Szabrownick/spool-film-processor/docs/screens/06_chem_fresh.png

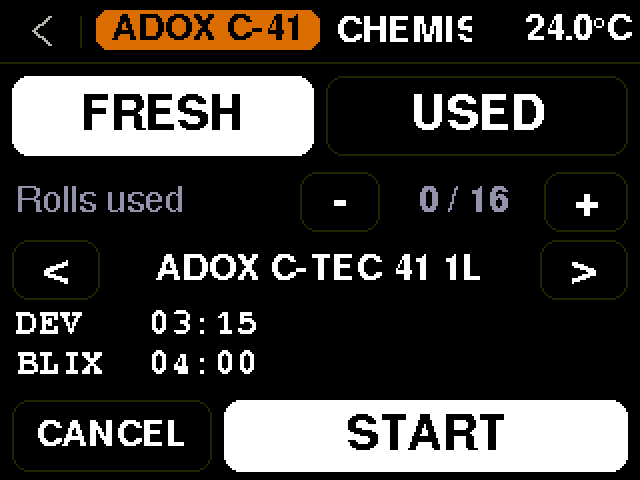
docs/screens/06_chem_fresh.png
