Szabrownick/spool-film-processor/docs/screens/19_confirm.png

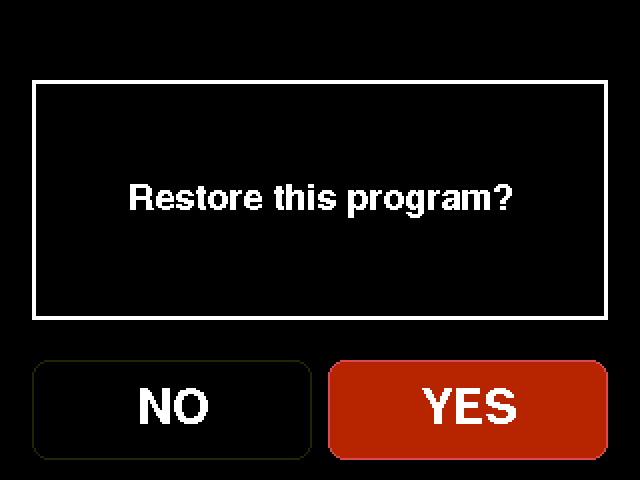
docs/screens/19_confirm.png
