Szabrownick/spool-film-processor/docs/screens/14b_step_edit_2.png

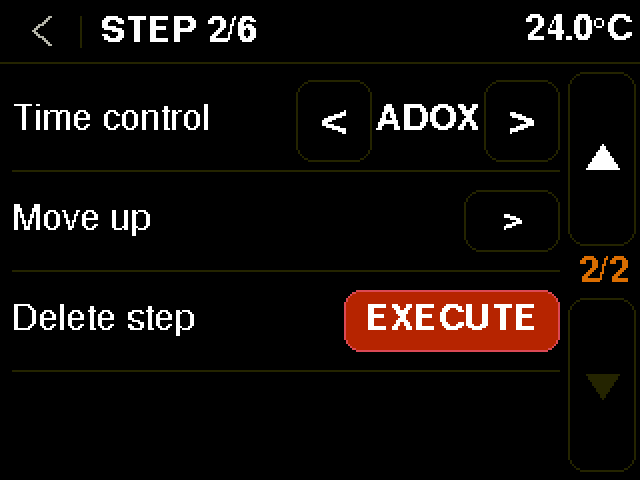
docs/screens/14b_step_edit_2.png
