Szabrownick/spool-film-processor/SpoolFilmProcessor/spool_logo.h

// Napis SPOOL (Loupe Negative Lab, logo/Spool logo.png) - 256 x 59 px, 1 bit/px, MSB = lewy piksel
#pragma once
#define SPOOL_WORD_W 256
#define SPOOL_WORD_H 59
static const uint8_t SPOOL_WORD[] PROGMEM = {
  0x00,0x00,0x0F,0x80,0x00,0x00,0x00,0x00,0x00,0x00,0x00,0x00,0x00,0x00,0x00,0x00,0x00,0x00,0x00,0x00,0x00,0x00,0x00,0x00,0x00,0x00,0x00,0x00,0x00,0x00,0x00,0x00,
  0x00,0x01,0xFF,0xFC,0x00,0x00,0x1F,0xFF,0xFF,0xC0,0x00,0x00,0x00,0x00,0x00,0xFF,0xFF,0xFF,0x00,0x00,0x00,0x00,0x00,0xF0,0x00,0x00,0x00,0x07,0xFF,0xE0,0x00,0x00,
  0x00,0x0F,0xFF,0xFF,0x80,0x00,0x1F,0xFF,0xFF,0xFC,0x00,0x00,0x00,0x00,0x3F,0xFF,0xFF,0xFF,0x80,0x00,0x00,0x00,0x3F,0xFF,0xC0,0x00,0x00,0x07,0xFF,0xE0,0x00,0x00,
  0x00,0x3F,0xFF,0xFF,0xE0,0x00,0x1F,0xFF,0xFF,0xFF,0x00,0x00,0x00,0x01,0xFF,0xFF,0xFF,0xFF,0x80,0x00,0x00,0x00,0xFF,0xFF,0xF8,0x00,0x00,0x07,0xFF,0xE0,0x00,0x00,
  0x00,0x7F,0xFF,0xFF,0xF8,0x00,0x1F,0xFF,0xFF,0xFF,0xC0,0x00,0x00,0x07,0xFF,0xFF,0xFF,0xFF,0x80,0x00,0x00,0x07,0xFF,0xFF,0xFE,0x00,0x00,0x07,0xFF,0xE0,0x00,0x00,
  0x01,0xFF,0xFF,0xFF,0xFC,0x00,0x1F,0xFF,0xFF,0xFF,0xE0,0x00,0x00,0x1F,0xFF,0xFF,0xFF,0xFF,0x80,0x00,0x00,0x0F,0xFF,0xFF,0xFF,0x80,0x00,0x07,0xFF,0xE0,0x00,0x00,
  0x03,0xFF,0xFF,0xFF,0xFF,0x00,0x1F,0xFF,0xFF,0xFF,0xF0,0x00,0x00,0x7F,0xFF,0xFF,0xFF,0xFF,0x80,0x00,0x00,0x3F,0xFF,0xFF,0xFF,0xC0,0x00,0x07,0xFF,0xE0,0x00,0x00,
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
  0x38,0x7C,0xF8,0x03,0xFF,0xFC,0x1F,0xFF,0xC7,0xC0,
  0x7F,0xFC,0xF8,0x01,0xFF,0xFC,0x1F,0xFF,0xC7,0xFF,
  0x7F,0xFC,0xF8,0x00,0xFF,0xF8,0x1F,0xFF,0x87,0xFF,
  0x3F,0xF8,0xF8,0x00,0x7F,0xF0,0x1F,0xFF,0x07,0xFF,
  0x1F,0xF0,0xF8,0x00,0x1F,0xC0,0x1F,0xFC,0x07,0xFF,
};
