Szabrownick/spool-film-processor/SpoolFilmProcessor/display.h

// =====================================================================
//  display.h  -  konfiguracja LovyanGFX dla wbudowanego ST7789 240x320
// =====================================================================
#pragma once
#define LGFX_USE_V1
#include <LovyanGFX.hpp>
#include "config.h"

class LGFX : public lgfx::LGFX_Device {
  lgfx::Panel_ST7789 _panel;
  lgfx::Bus_SPI      _bus;
public:
  LGFX() {
    {
      auto cfg = _bus.config();
      cfg.spi_host    = SPI2_HOST;
      cfg.spi_mode    = 3;            // CS na stale do GND -> wymagany MODE 3
      cfg.freq_write  = 40000000;
      cfg.freq_read   = 16000000;
      cfg.spi_3wire   = true;
      cfg.use_lock    = true;
      cfg.dma_channel = SPI_DMA_CH_AUTO;
      cfg.pin_sclk    = PIN_TFT_SCLK;
      cfg.pin_mosi    = PIN_TFT_MOSI;
      cfg.pin_miso    = -1;
      cfg.pin_dc      = PIN_TFT_DC;
      _bus.config(cfg);
      _panel.setBus(&_bus);
    }
    {
      auto cfg = _panel.config();
      cfg.pin_cs           = PIN_TFT_CS;
      cfg.pin_rst          = PIN_TFT_RST;
      cfg.pin_busy         = -1;
      cfg.memory_width     = 240;
      cfg.memory_height    = 320;
      cfg.panel_width      = 240;
      cfg.panel_height     = 320;
      cfg.offset_x         = 0;
      cfg.offset_y         = 0;
      cfg.offset_rotation  = 0;
      cfg.readable         = false;
      cfg.invert           = TFT_INVERT;
      cfg.rgb_order        = false;
      cfg.dlen_16bit       = false;
      cfg.bus_shared       = false;
      _panel.config(cfg);
    }
    setPanel(&_panel);
  }
};

LGFX lcd;   // fizyczny wyswietlacz; ekrany rysuja przez "tft" (patrz ui.h)

// Podswietlenie PWM na GPIO0
void backlightBegin() {
  ledcAttach(PIN_TFT_BL, 5000, 8);
  ledcWrite(PIN_TFT_BL, 255);
}
void backlightSet(int percent) {
  percent = constrain(percent, 5, 100);
  ledcWrite(PIN_TFT_BL, (uint32_t)(percent * 255 / 100));
}
