Szabrownick/spool-film-processor/(commit log)

2026-10-16 Spool Film Processor v2.1
    DIY film developing processor (C-41, B&W, E-6, ECN-2, RA-4) on ESP32-C3
    with a touch UI, TMC2209 agitation, temperature and chemistry-reuse
    compensation and a tank thermal model.
    - SpoolFilmProcessor/: Arduino source
    - firmware/: v2.1 binaries, flashing scripts, Arduino IDE ZIP
    - documentation.html + PDF, INSTRUCTIONS.md (Polish versions in docs/pl)
    - docs/screens, docs/photos: device screenshots, build photos, Fusion 360 model
2026-10-16 README: build diagrams from the documentation (wiring, speaker, pinouts, shaft seal)
2026-10-16 Pre-wash detection rework (v2.2, not yet released)
    - fast drop (>= 1 C within 2 s) = water poured out; tank cooling counted from the start of the drop
    - rise of 0.2 C after draining = tank refilled with water at the current reading
    - full tank: water temperature = current reading; slow changes are not a drain
    - colder tap water recognised (reading levels off > room + 5 C) and the drain is undone
    - slow probe fallbacks: back near room temperature, or NEXT while the reading was falling
    - panel shows water / drained (last water, time empty) / waiting; realistic test captures
    [config.h, ui.h]
2026-10-16 README: screenshots from the device running v2.2, drained pre-wash screen
2026-10-16 v2.3: pre-wash drain detection tuned on the real probe (0.4 C / 12 s, drain start at last near-max sample, quiet period after colder-water undo), serial [WODA] log
